damienmaguire/Tesla-Drive-Unit/Signal_wiring.jpg

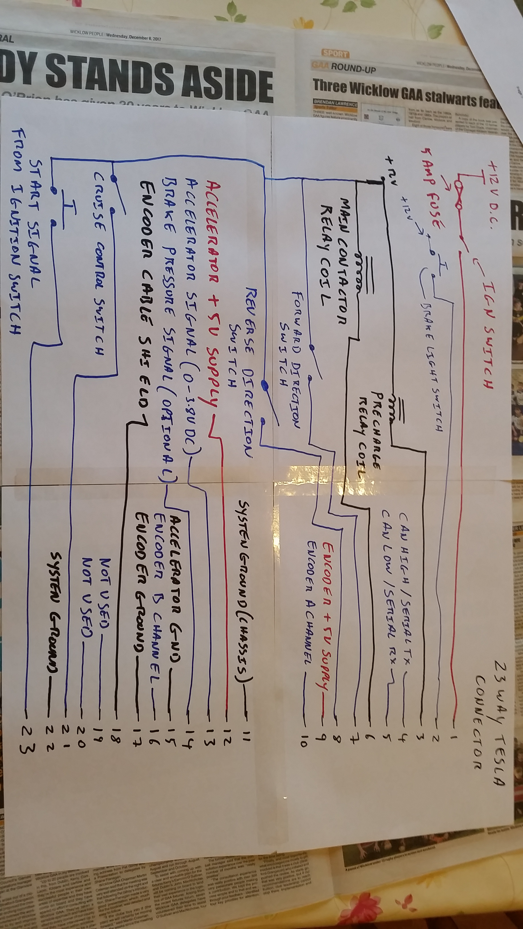
Signal_wiring.jpg
