damienmaguire/Tesla-Drive-Unit/HV_wiring.jpg

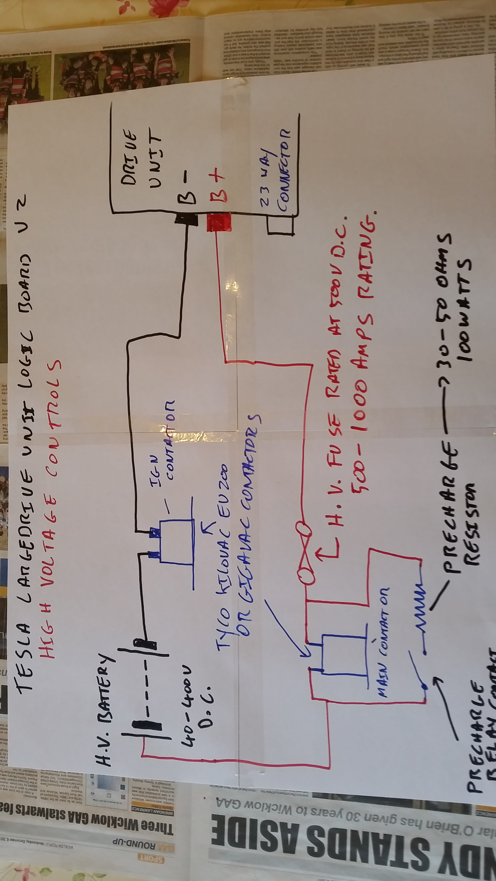
HV_wiring.jpg
