damienmaguire/Tesla-Drive-Unit/12v_signals.jpg

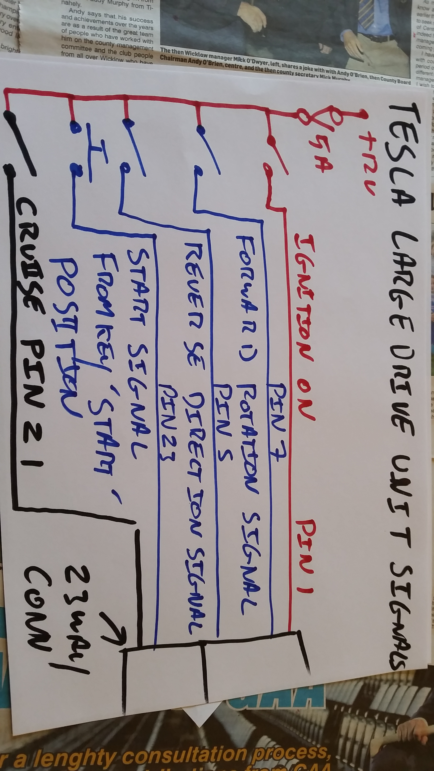
12v_signals.jpg
