damienmaguire/Tesla-Drive-Unit/ESP8266_WiFi_V1.jpg

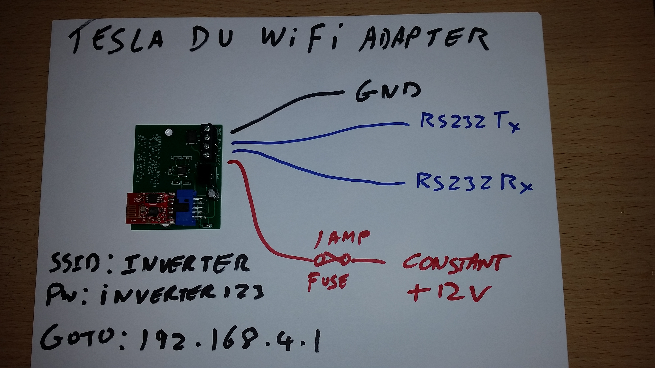
ESP8266_WiFi_V1.jpg
