damienmaguire/Tesla-Drive-Unit/Throttle_pedal.jpg

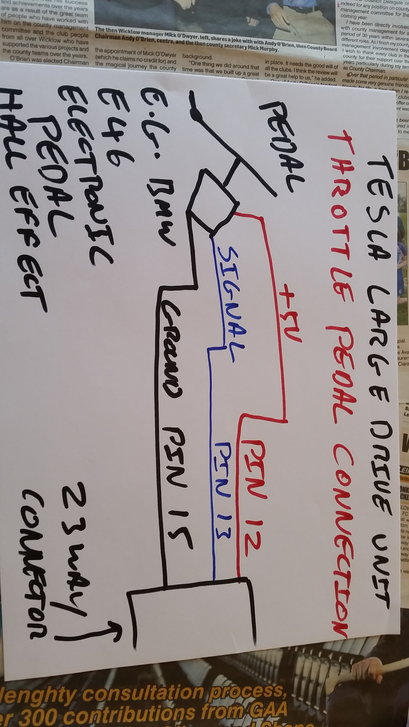
Throttle_pedal.jpg
