damienmaguire/Tesla-Drive-Unit/V4b/Tesla_V4B_BOM_JLC.xls

Comment | Designator | Package | LCSC Part #
74HCT4052D | IC12 | SOIC-16_3.9x9.9x1.27P | C87281
74LVC2G17GW | IC13 | 74LVC2G17GW,125 | C80500
0.1uF | C11,C60,C52,C9,C42,C35,C34,C38,C10,C4,C29 | 0805_C | C49678
1N5 | C57,C51 | 0805_C | C1717
1nF | C31,C30,C5 | 0805_C | C46653
1uF | C16,C59,C58,C54,C53,C48,C49,C50,C28,C25,C27,C24,C32,C33,C37,C36,C2,C23,C22,C20,C21 | 0805_C | C28323
10nF | C41,C43,C44,C39,C40,C45 | 0805_C | C1710
22pF | C13,C14 | 0805_C | C1804
150PF | C55,C47 | 0805_C | C1716
330PF | C46,C56 | 0805_C | C51207
CD74HC30M | IC10 | SOIC-14_3.9x8.7x1.27P | C5631
10pF | C18,C19 | 0805_C | C1785
10uF | C3,C1,C17,C26 | 0805_C | C15850
LD1117-3.3 | LD1 | SOT-223 | C347229
LED0805 | LED1,LED2 | CHIPLED_0805 | C84256
LM2596S-5.0_NOPB | IC1 | TO-263-5 | C10002
LM2664M6X_NOPB | IC2 | SOT-23-6L | C108573
LM2901DT | IC8 | SOIC-14_3.9x8.7x1.27P | C142961
10uH | L2 | 0603 | C1035
MC74HCT573ADWR2G | IC9 | SOIC-20_7.5x12.8x1.27P | C6000
MMBT3904 | Q1 | SOT-23-3 | C20526
120Ω | R68 | 0805_R | C17437
1KΩ | R2,R28,R29,R19,R17,R22 | 0805_R | C17513
1.5KΩ | R7,R15,R11,R12,R9 | 0805_R | C4310
2.7KΩ | R58,R45 | 0805_R | C17530
3.3KΩ | R1 | 0805_R | C26010
4.7KΩ | R23,R6,R46,R14,R10,R13,R8,R57 | 0805_R | C17673
5.1KΩ | R54,R47 | 0805_R | C27834
6.8KΩ | R48,R55 | 0805_R | C17772
10KΩ | R21,R20,R24,R26,R25,R27,R32,R31,R38,R63,R62,R43,R39,R33,R34,R18 | 0805_R | C17414
15kΩ | R52,R53 | 0805_R | C17475
22kΩ | R30 | 0805_R | C17560
47kΩ | R64 | 0805_R | C17713
100KΩ | R65,R61,R66,R67 | 0805_R | C17407
100Ω | R3 | 0805_R | C17408
147kΩ | R50,R44,R51 | 0805_R | C17470
470 | R16 | 0805_R | C17710
470kΩ | R59,R60 | 0805_R | C17709
560Ω | R37,R40,R41,R35,R36,R42 | 0805_R | C28636
910Ω | R49,R56 | 0603_R | C23264
SN65HVD234 | IC4 | SOIC-8_3.9x4.9x1.27P | C99818
SS54B | D1,D2 | SMA,DO-214AC | C22452
STM32F103RBT6 | IC6 | LQFP-64_10.0x10.0x0.5P | C8735
470UH | L1 | SMD-PIND-12.5x12.5x8_2.9x5.4 | C169382
100UF 6.3V | C8,C7,C15 | CASE-B_3528 | C16133
470uF 25V | C6 | SMD-ECAP-10x10 | C249931
8MHZ | X1 | SMD-5032_2P | C115962
