damienmaguire/Tesla-Drive-Unit/HV_Control_Wiring.jpg

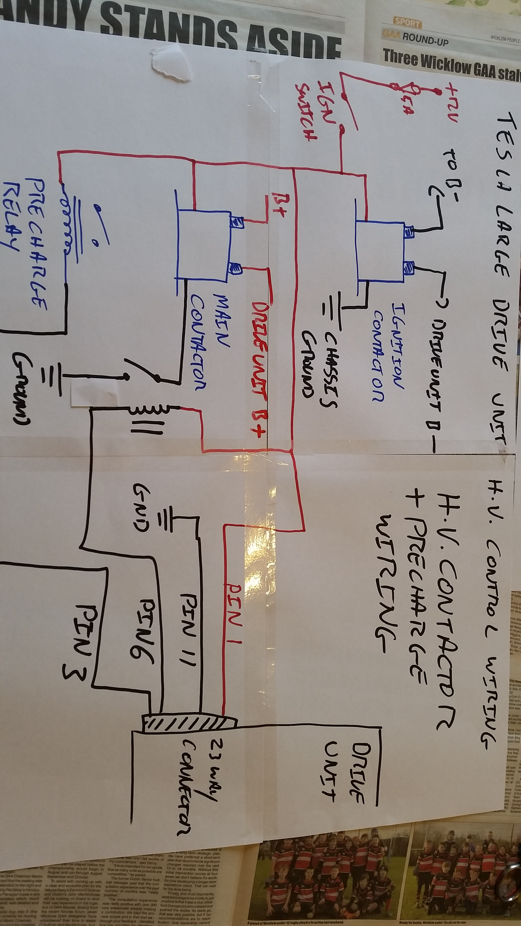
HV_Control_Wiring.jpg
