damienmaguire/Tesla-Drive-Unit/Tesla_V3 - Schematic.pdf

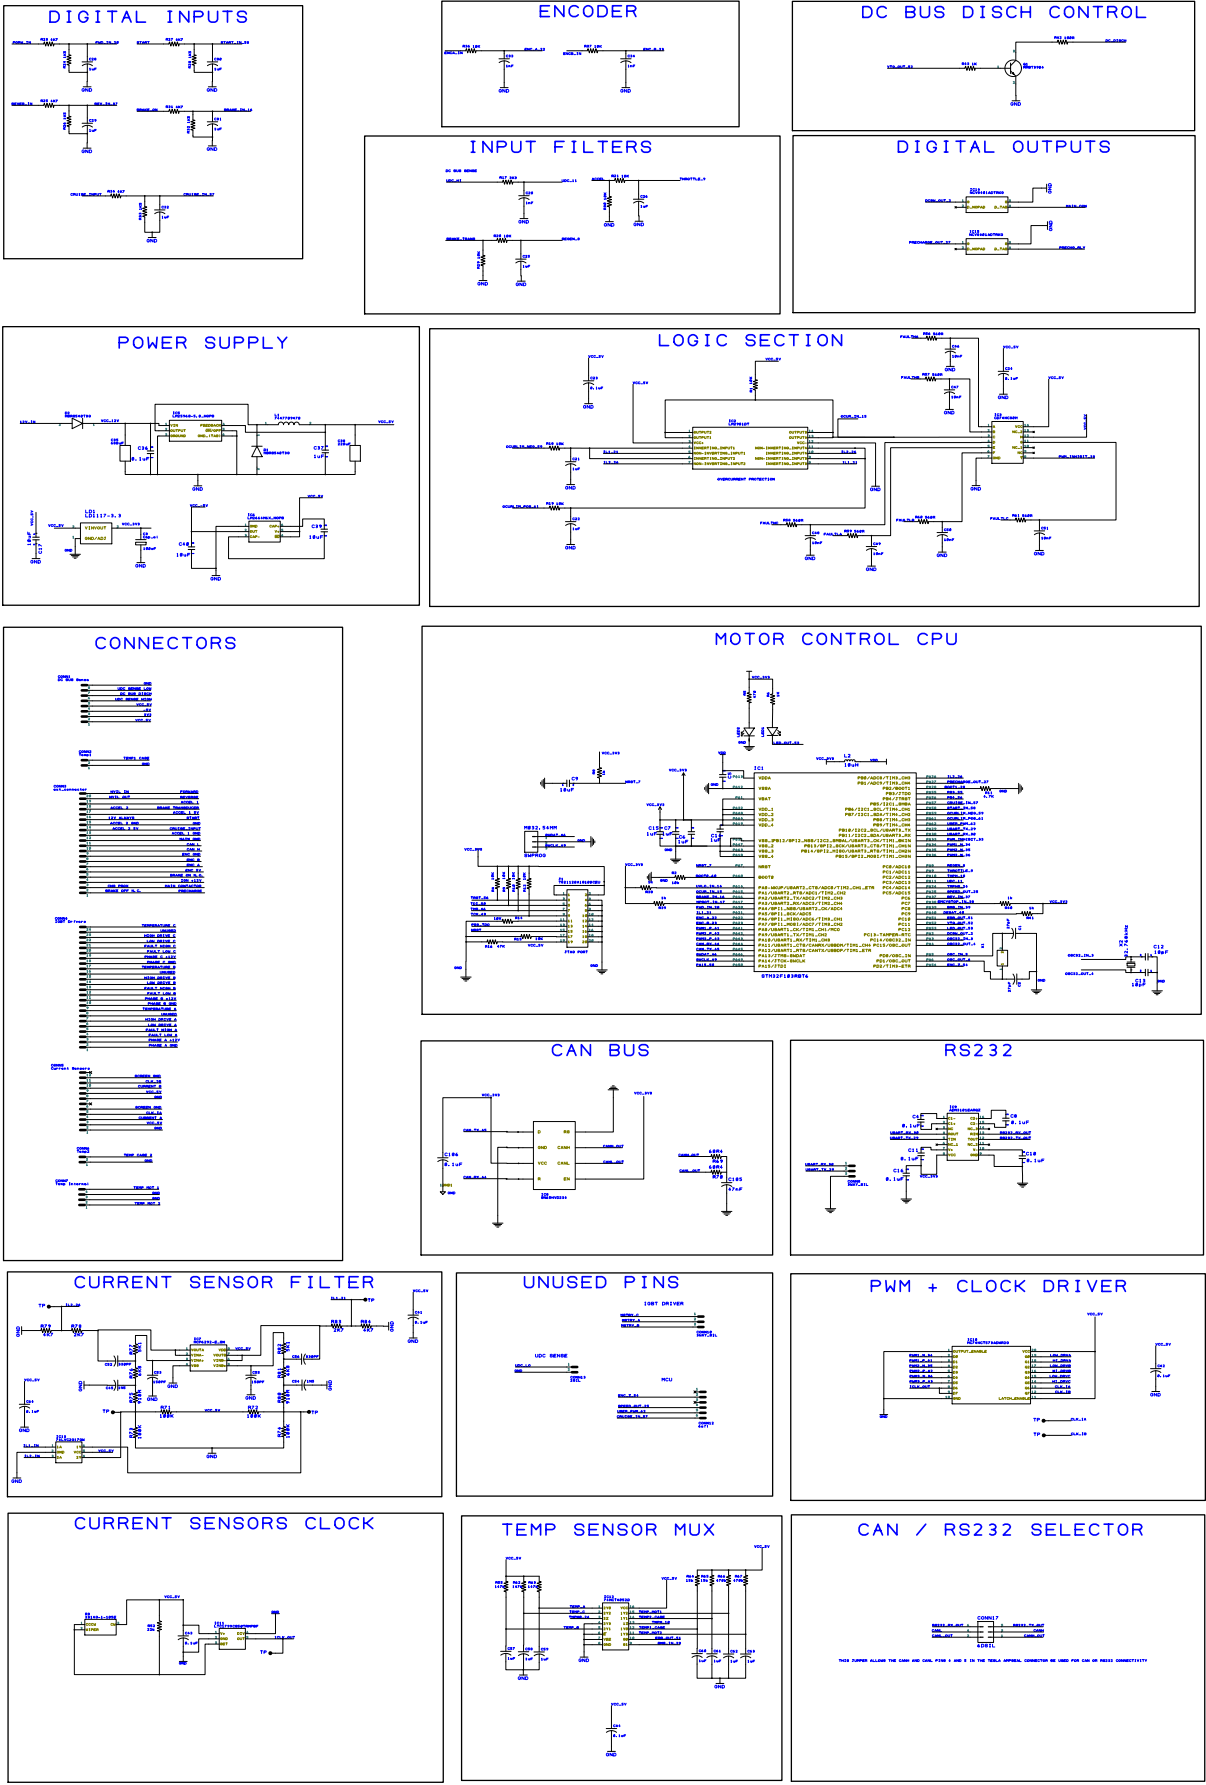
[picture p13: page 1]
