damienmaguire/Tesla-Drive-Unit/V4b/Tesla_V4B - Schematic.pdf

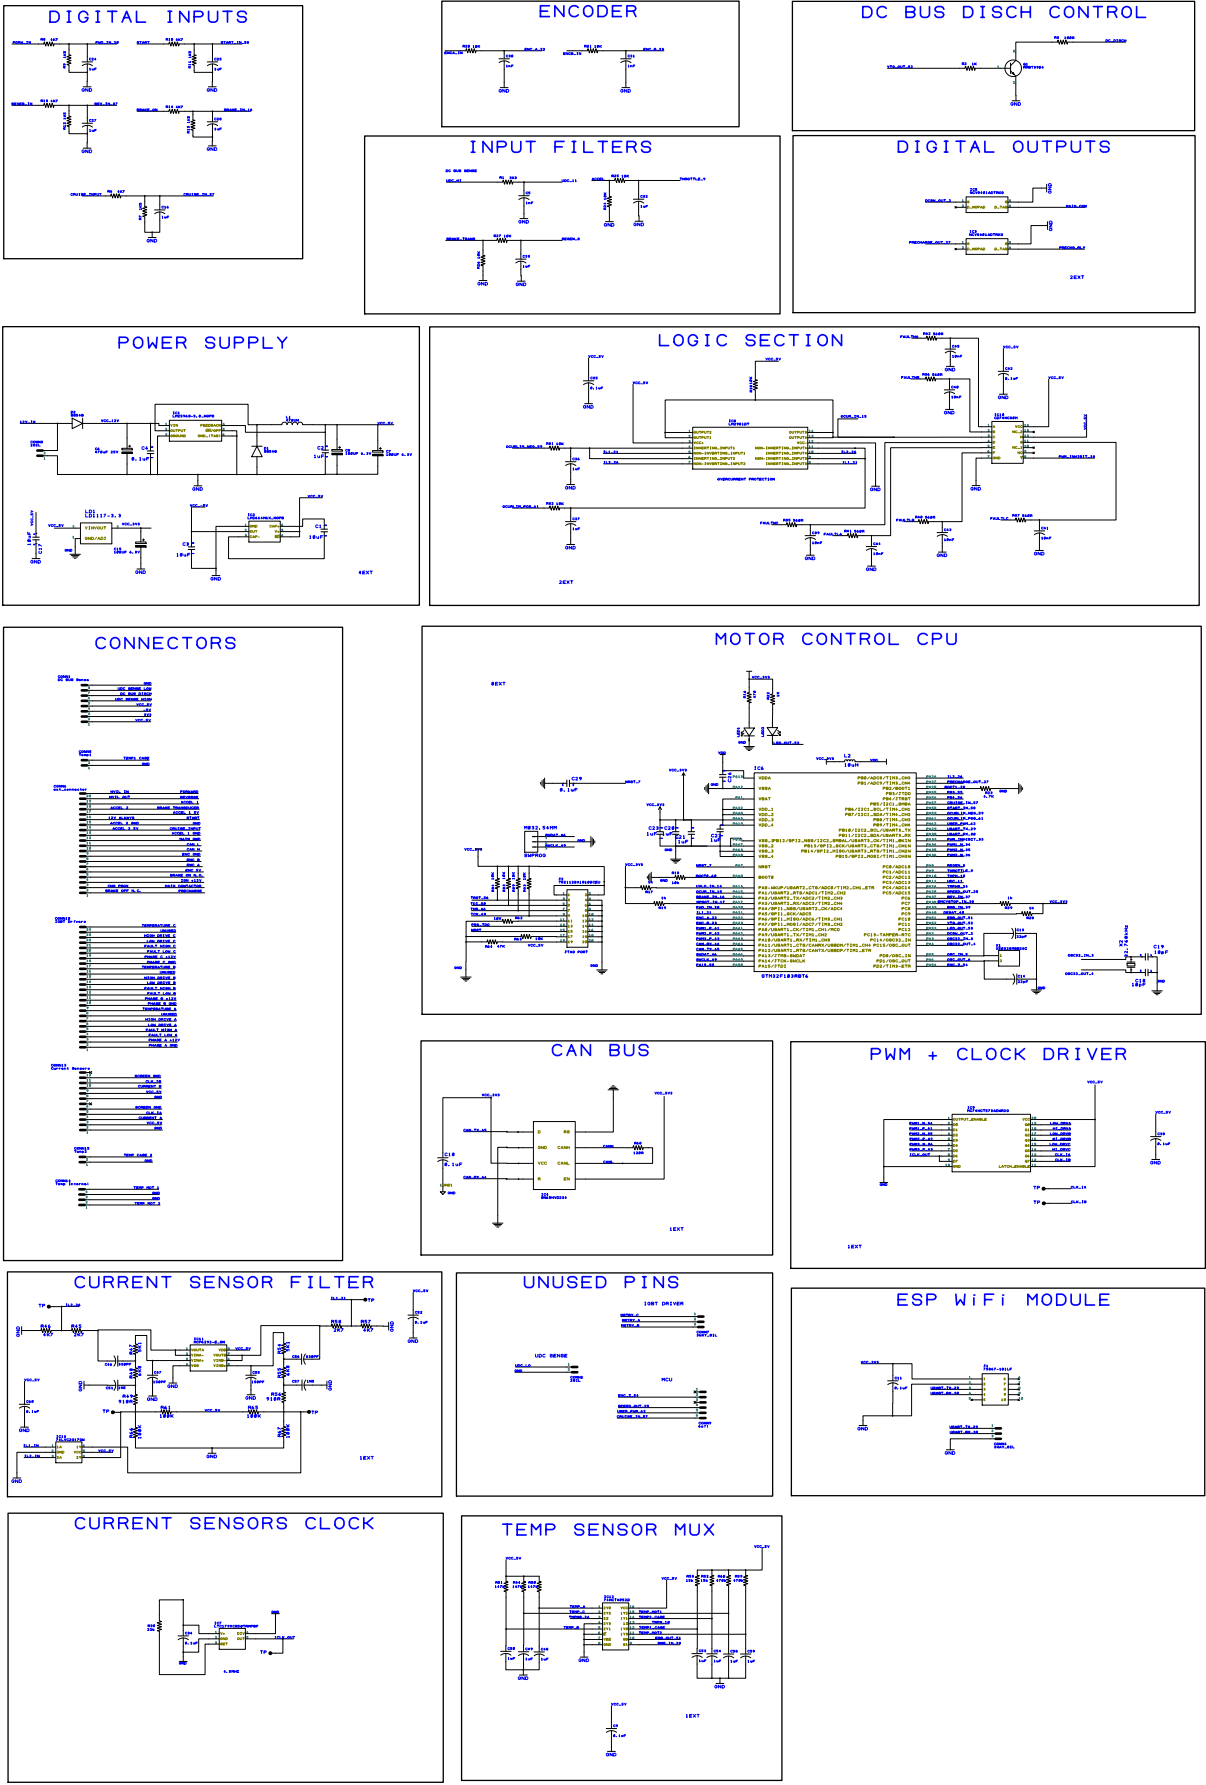
[picture p14: page 1]
