damienmaguire/Tesla-Drive-Unit/Tesla_V3 - PCB.pdf

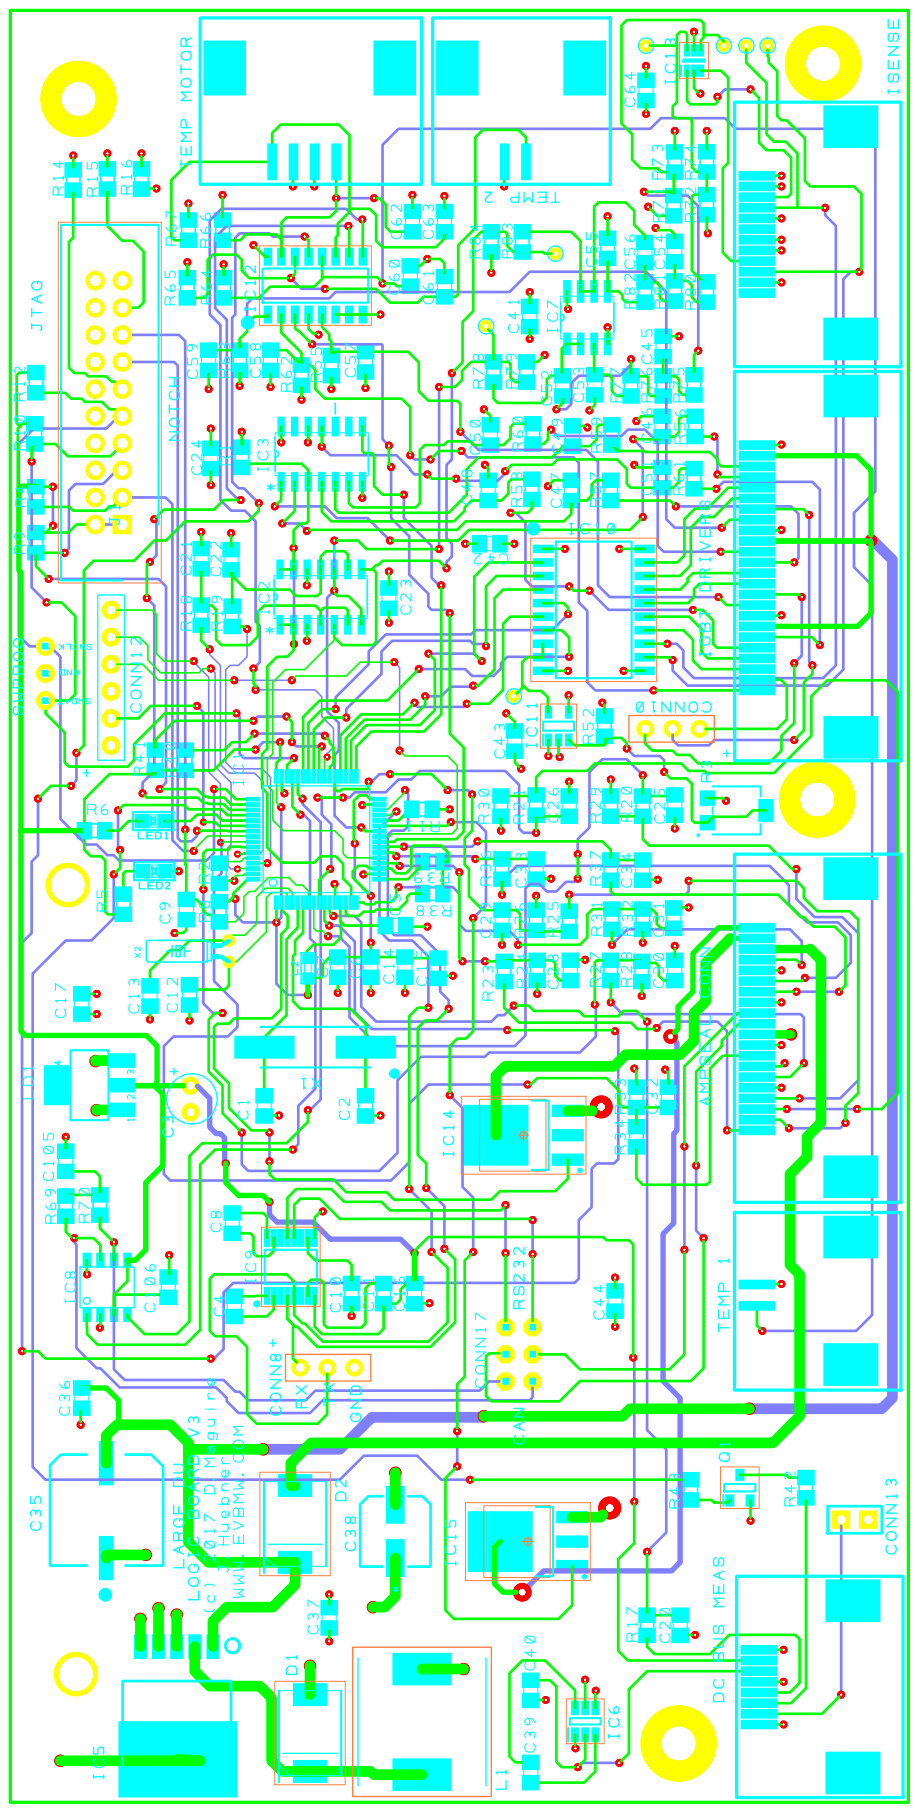
[picture p15: page 1]
