damienmaguire/Tesla-Drive-Unit/V4b/Tesla_V4B - PCB.pdf

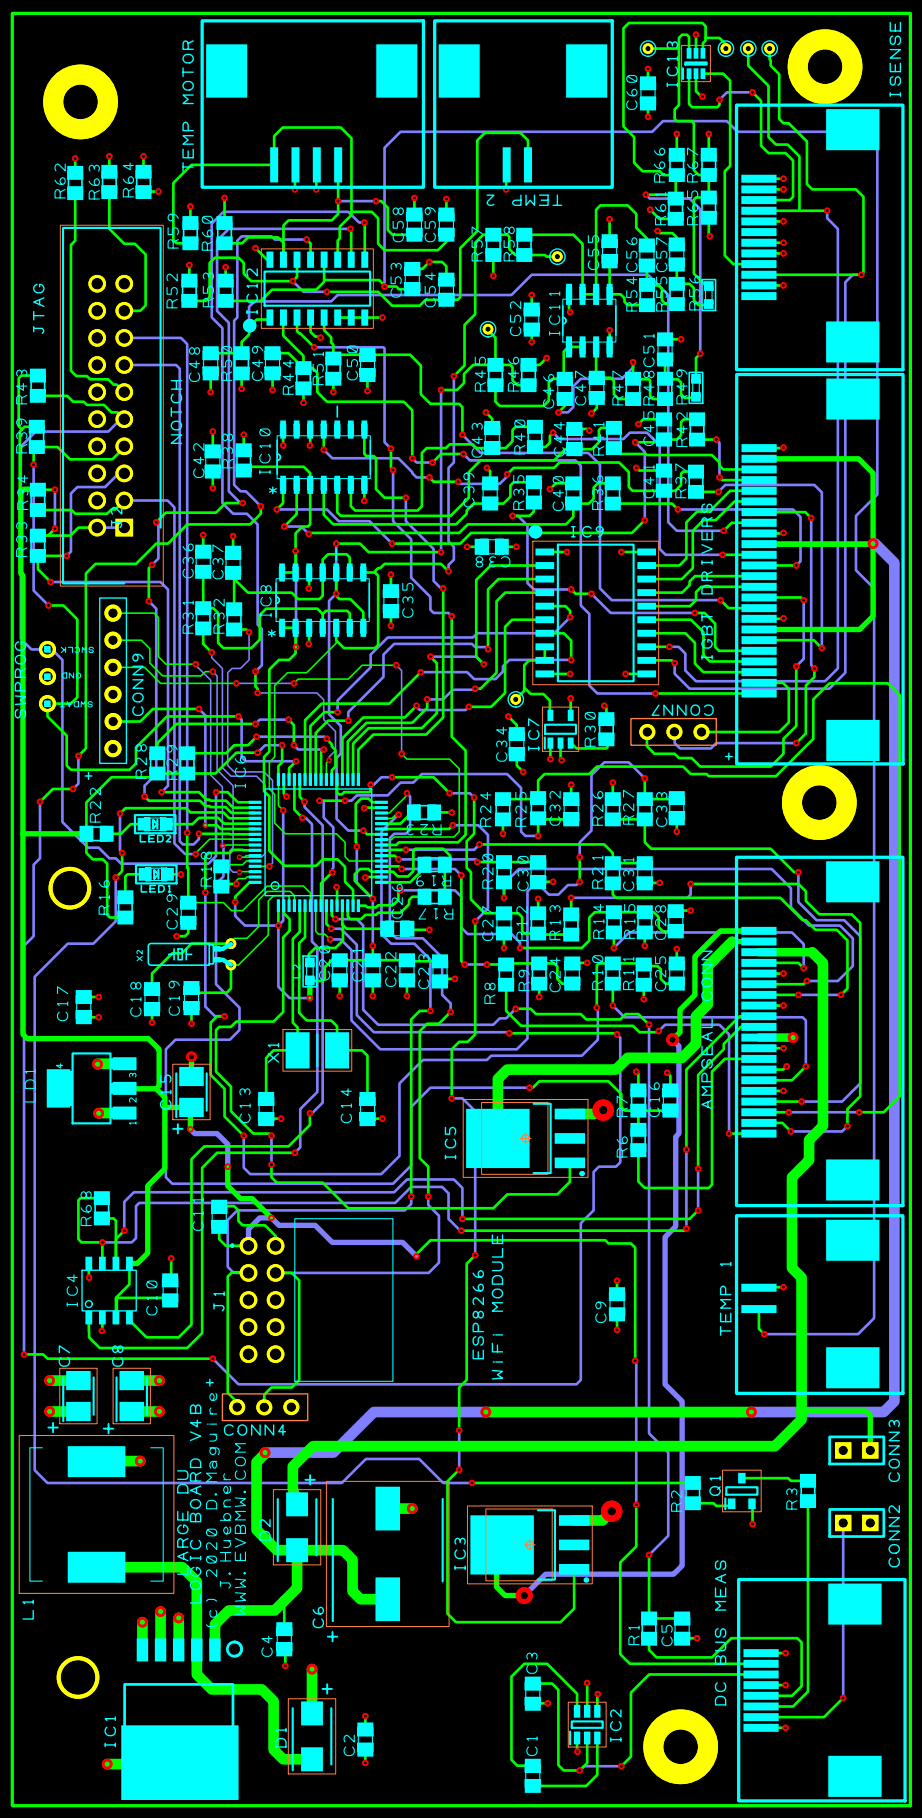
[picture p16: page 1]
