damienmaguire/Tesla-Drive-Unit/Tesla_V2 - Schematic.pdf

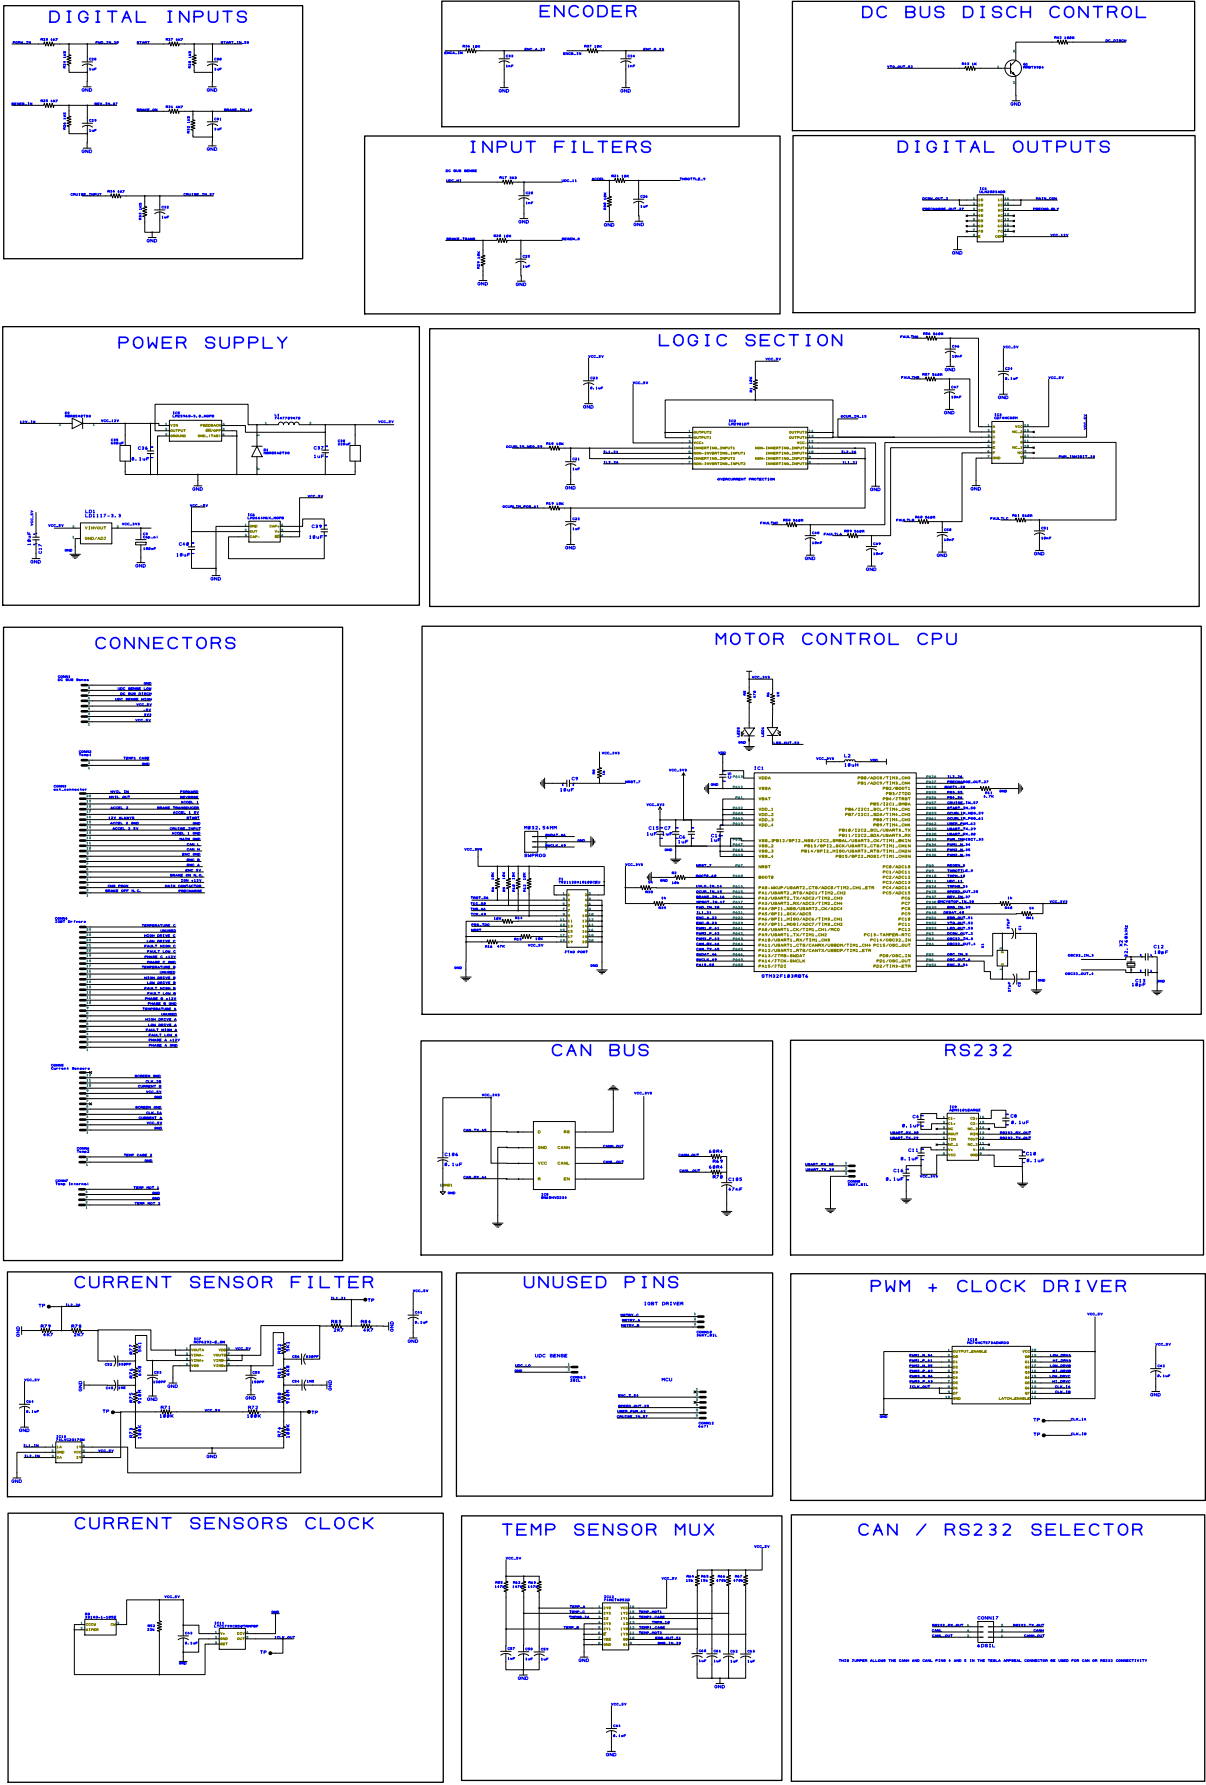
[picture p17: page 1]
