damienmaguire/Tesla-Drive-Unit/Tesla_V2 - PCB.pdf

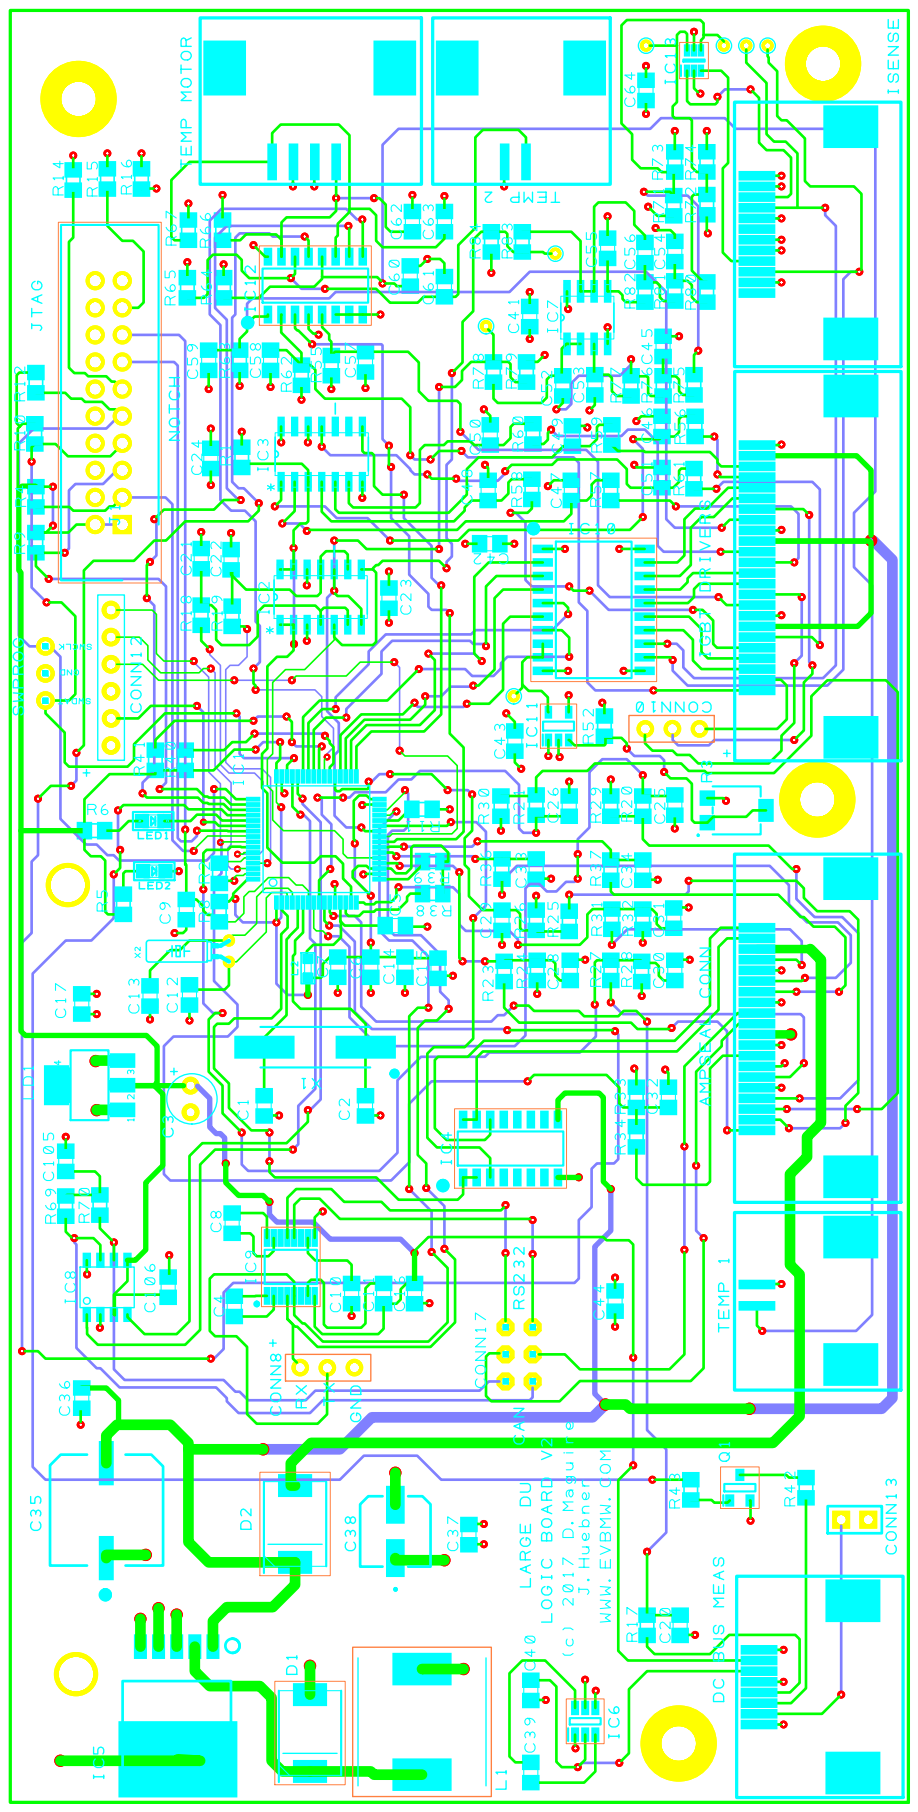
[picture p18: page 1]
