damienmaguire/Tesla-Drive-Unit/(list of files, drawings)

Other design files:
Tesla_V1.pcb
Tesla_V2.pcb
Tesla_V3.pcb
V4A/Tesla_V4a.pcb
V4b/Tesla_V4B.pcb
