damienmaguire/Tesla-Drive-Unit/params_os1_lv1.txt

{
    "boost": "15000",
    "fweak": "200",
    "fpconst": "1000",
    "fslipmin": "1",
    "fslipmax": "3",
    "polepairs": "2",
    "ampmin": "5",
    "encflt": "1",
    "encmode": "1",
    "fmin": "0.28",
    "fmax": "200",
    "numimp": "36",
    "syncmode": "0",
    "syncofs": "0",
    "snsm": "2",
    "pwmfrq": "1",
    "pwmpol": "0",
    "deadtime": "63",
    "ocurlim": "-300",
    "minpulse": "1000",
    "il1gain": "-1",
    "il2gain": "-1",
    "udcgain": "7.59",
    "udcofs": "0",
    "udclim": "380",
    "snshs": "1",
    "chargemode": "0",
    "chargecur": "0",
    "chargekp": "80",
    "chargeflt": "8",
    "potmin": "850",
    "potmax": "4095",
    "pot2min": "4095",
    "pot2max": "4095",
    "brknompedal": "-1",
    "brkpedalramp": "1",
    "brknom": "1",
    "brkmax": "1",
    "brkrampstr": "10",
    "brkout": "-50",
    "idlespeed": "-100",
    "idlethrotlim": "50",
    "idlemode": "1",
    "speedkp": "0.18",
    "speedflt": "5",
    "cruisemode": "0",
    "bmslimhigh": "100",
    "bmslimlow": "-1",
    "udcmin": "20",
    "udcmax": "380",
    "udcsw": "20",
    "pwmfunc": "0",
    "pwmgain": "100",
    "pwmofs": "0",
    "speedgain": "6000",
    "fslipspnt": "-1",
    "ampnom": "0",
    "version": "3.28",
    "opmode": "0",
    "udc": "43.03",
    "idc": "0",
    "il1": "0",
    "il2": "0",
    "ilmax": "3.28",
    "uac": "0",
    "il1rms": "0",
    "il2rms": "0",
    "id": "0.09",
    "iq": "0.09",
    "p": "0",
    "q": "0",
    "s": "0",
    "pf": "1",
    "t": "0",
    "fstat": "0",
    "speed": "0",
    "amp": "0",
    "pot": "794",
    "pot2": "19",
    "potnom": "-1",
    "dir": "-1",
    "tmphs": "-115",
    "tmpm": "-17600",
    "uaux": "16.5",
    "din_cruise": "0",
    "din_start": "0",
    "din_brake": "0",
    "din_mprot": "1",
    "din_forward": "0",
    "din_reverse": "1",
    "din_emcystop": "1",
    "din_ocur": "0",
    "din_bms": "0",
    "tm_meas": "8"
}
